riktw/nixiewatch/README.md

# Nixie (ok, panaplex) watch
hardware and software for a panaplex watch.

More info can be found on the corresponding [blog post.](https://justanotherelectronicsblog.com/?p=1190)
