riktw/nixiewatch/hw/Nixiewatch.pdf

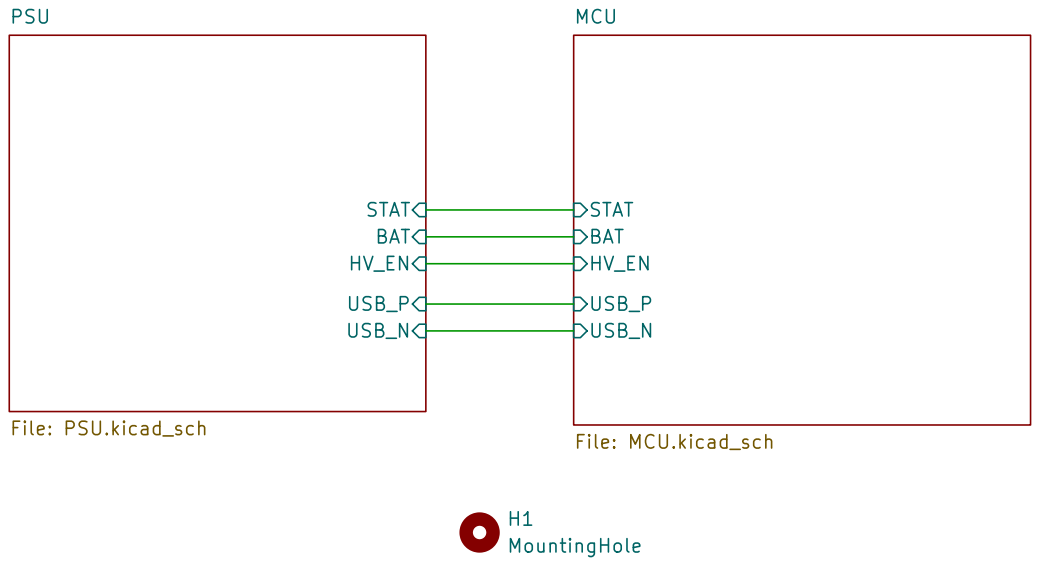
[picture p1: page 1]

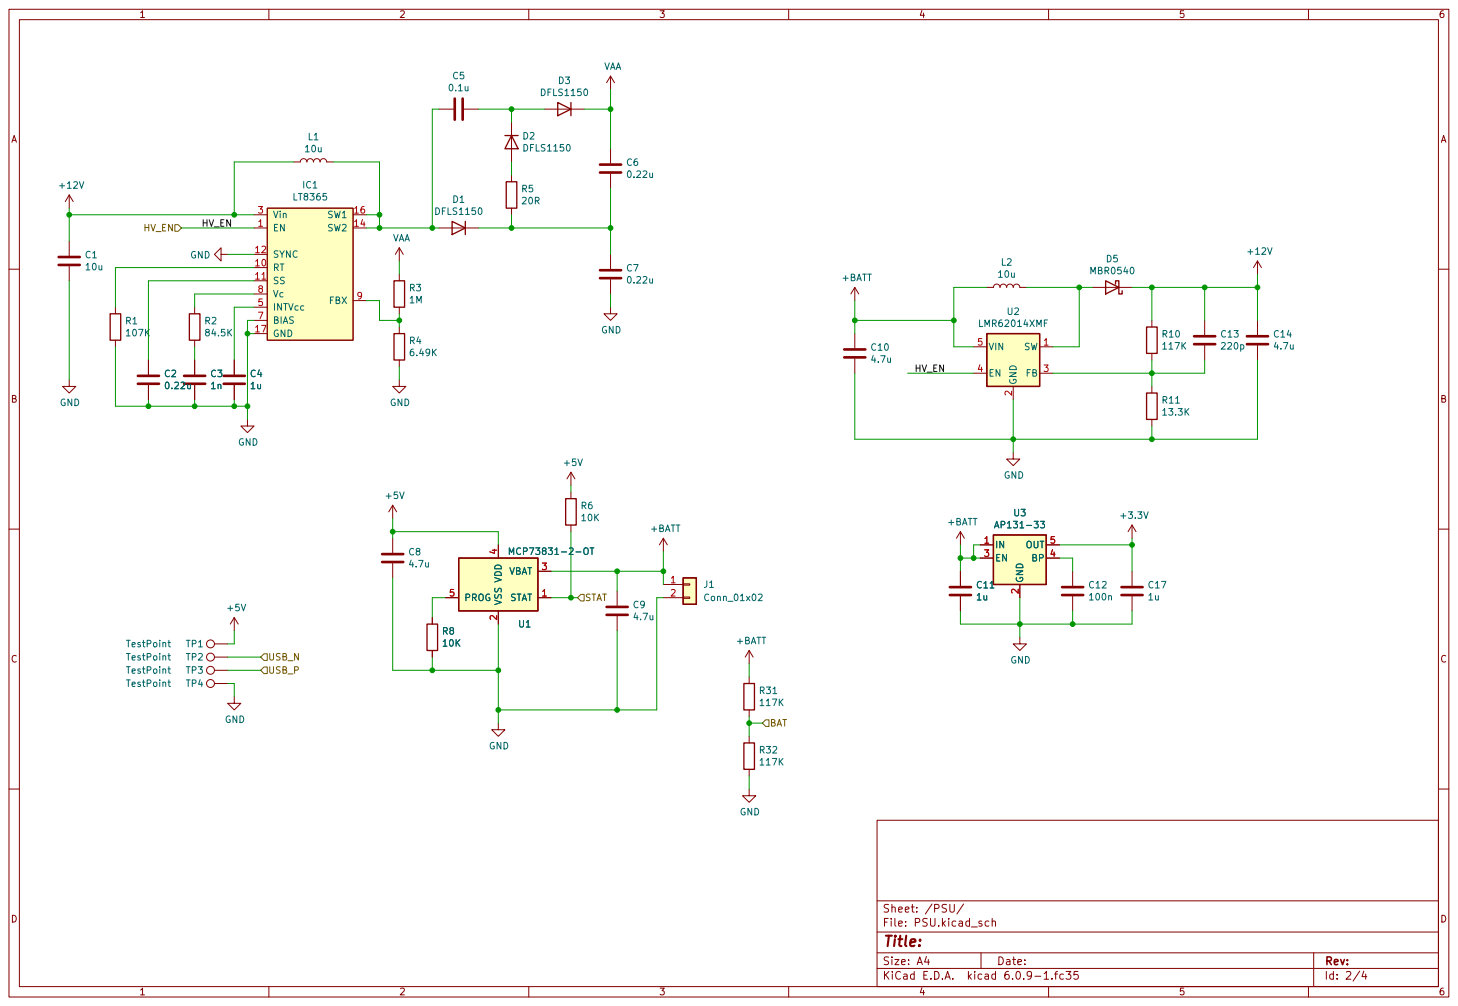
[picture p2: page 2]

2 EN 3 BP 4 OUT 5 U3 AP131-33 +BATT

File: PSU.kicad_sch Sheet: /PSU/
Id: 2/4 Title:

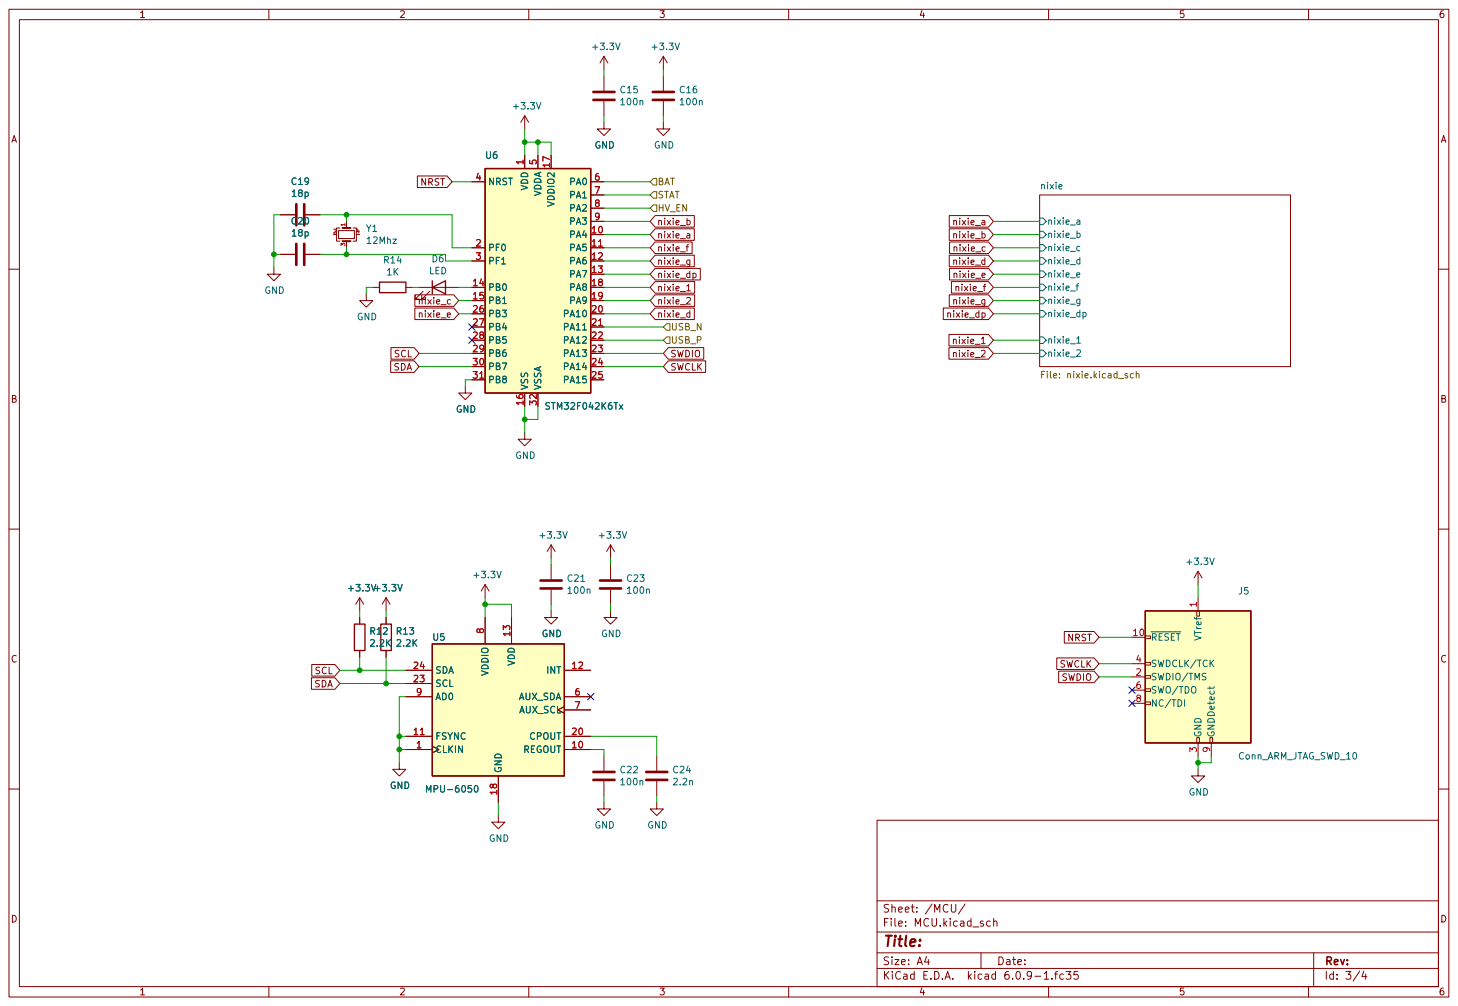
[picture p3: page 3]

1 PA4 10 PA5 11 PA6 12 PA7 13 PB0 14 PB1 15 VSS 16 VDDIO2 17 PA8 18 PA9 19 PF0 2 PA10 20 PA11 21 PA12 22 PA13 23 PA14 24 PA15 25 PB3 26 PB4 27 PB5 28 PB6 29 PF1 3 PB7 30 PB8 31 VSSA 32 NRST 4 VDDA

3 SWDCLK/TCK 4 SWO/TDO 6 NC/TDI 8 GNDDetect 9

File: MCU.kicad_sch Sheet: /MCU/
Id: 3/4 Title:

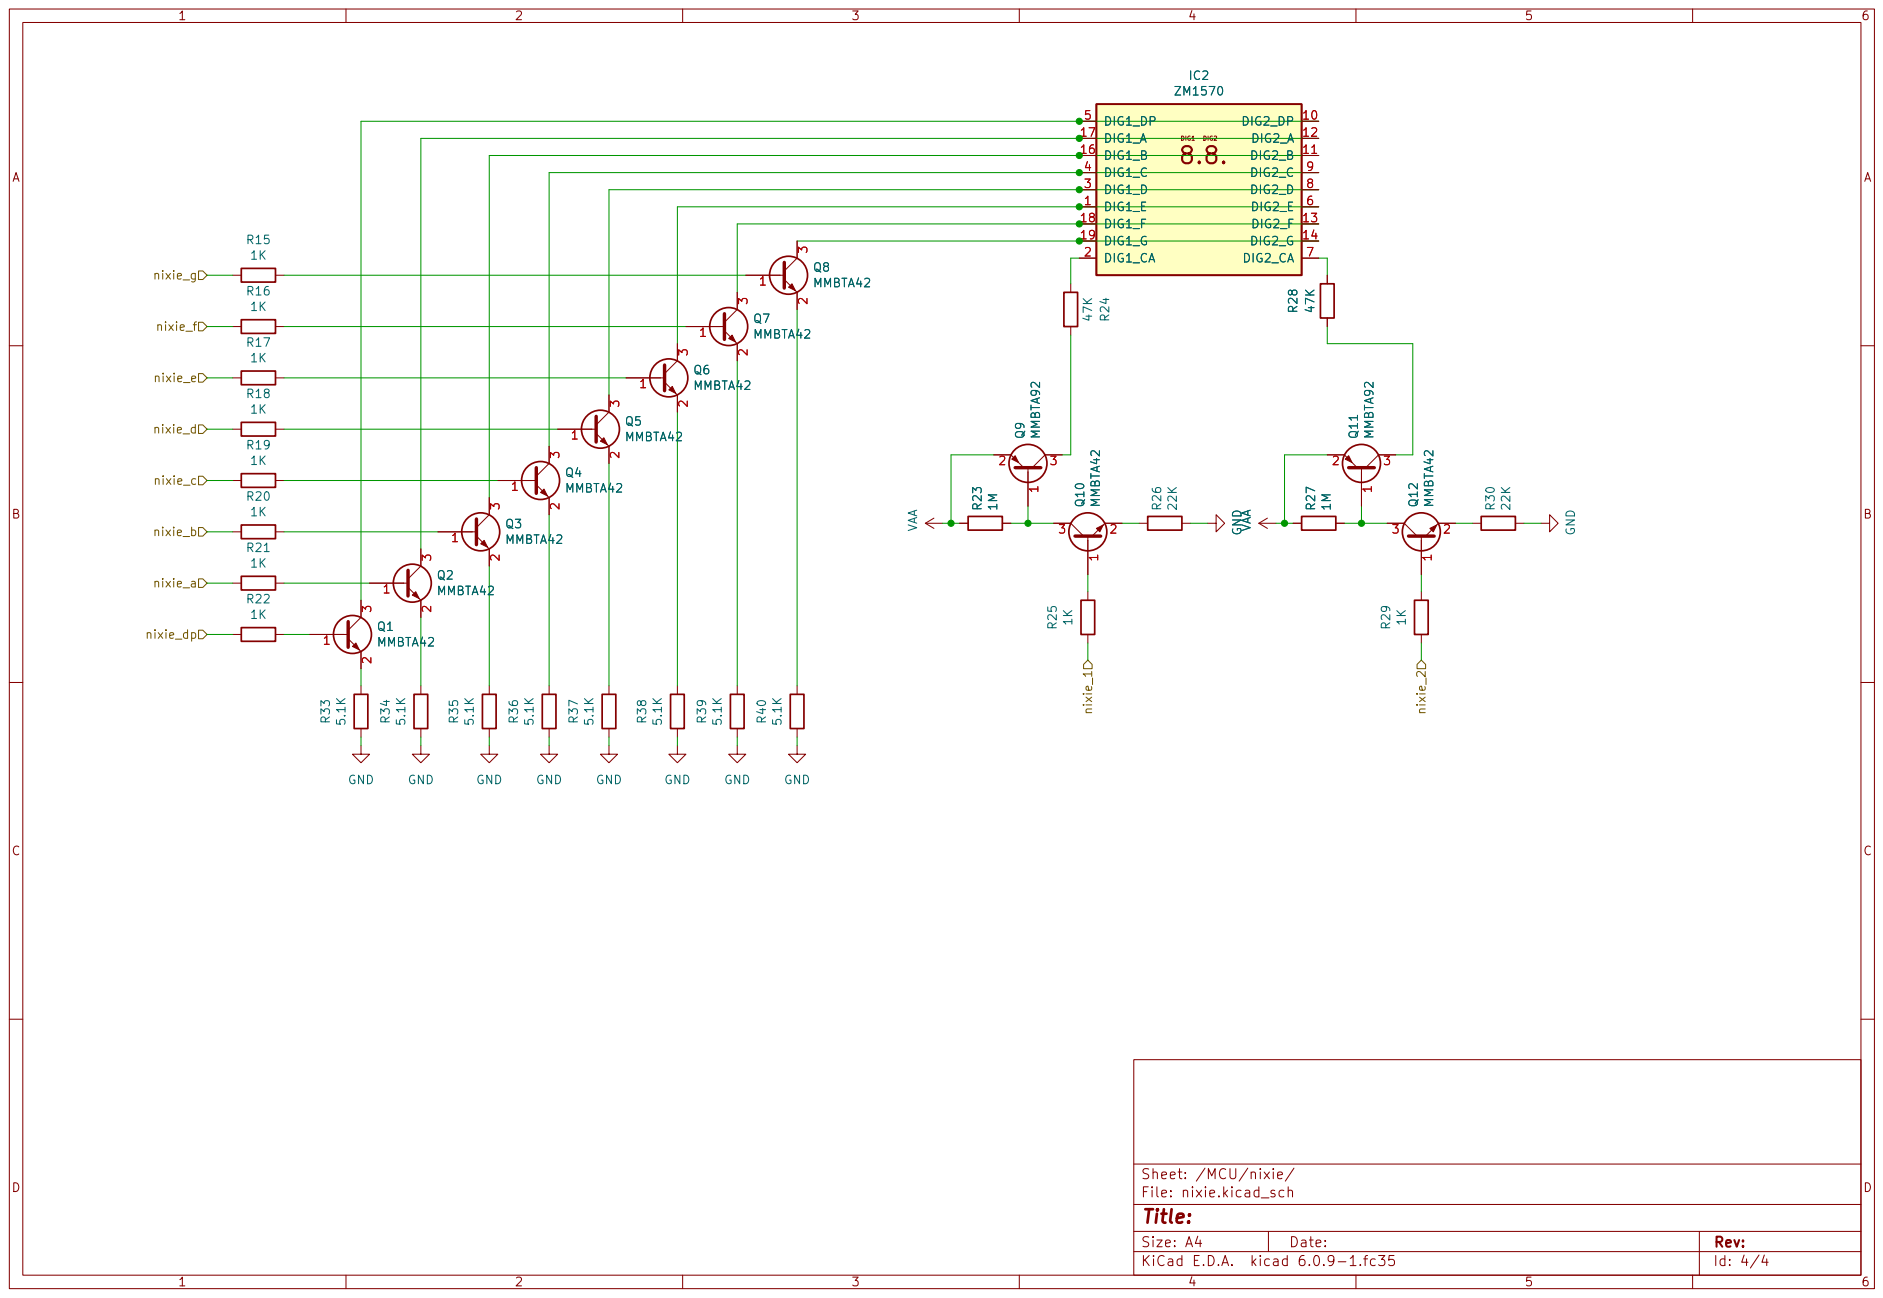
[picture p4: page 4]

File: nixie.kicad_sch Sheet: /MCU/nixie/
Id: 4/4 Title:
