riktw/nixiewatch/hw/Nixiewatch.kicad_pcb

## KiCad design hw/Nixiewatch.kicad_pcb (2022-12-20)

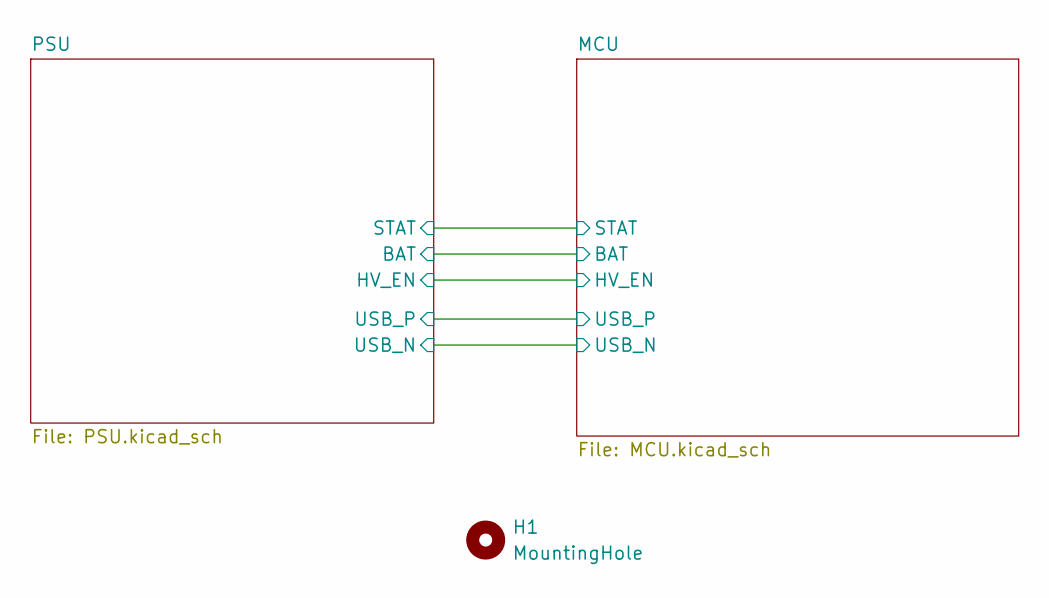
[picture p5: schematic Nixiewatch.kicad_sch]

Parts:
H1: MountingHole; MountingHole_2.2mm_M2

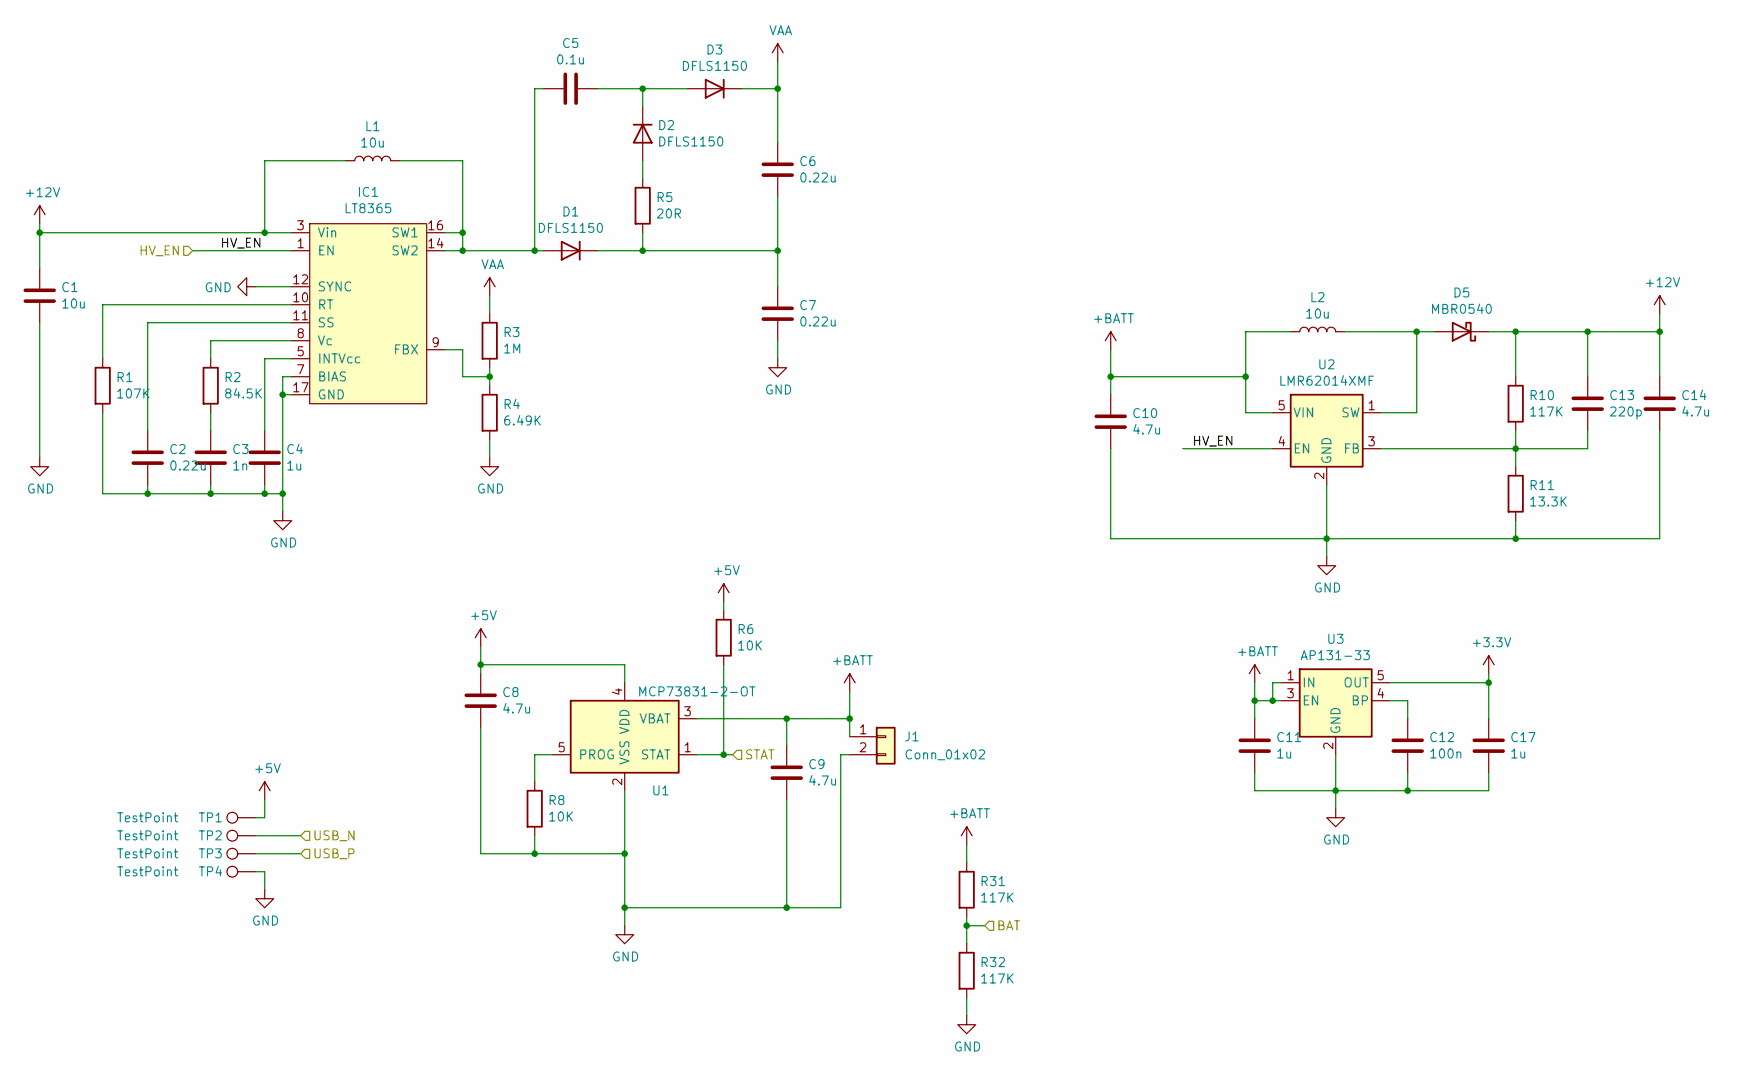
[picture p6: schematic PSU.kicad_sch]

Parts:
C1: 10u; C_0805_2012Metric_Pad1.15x1.40mm_HandSolder
C2: 0.22u; C_0603_1608Metric
C3: 1n; C_0603_1608Metric
C4, C11, C17: 1u; C_0603_1608Metric
C5: 0.1u; C_1206_3216Metric
C6, C7: 0.22u; C_1206_3216Metric
C8, C9, C10, C14: 4.7u; C_0603_1608Metric
C12: 100n; C_0603_1608Metric; LCSC C14663
C13: 220p; C_0603_1608Metric
D1, D2, D3: DFLS1150; D_SOD-123
D5: MBR0540; D_SOD-123
IC1: LT8365; MSOP-16-3x4.039_HV
J1: Conn_01x02; PinHeader_1x02_P2.54mm_Vertical
L1, L2: 10u; L_Coilcraft_XxL4020
R1: 107K; R_0603_1608Metric
R2: 84.5K; R_0603_1608Metric
R3: 1M; R_1206_3216Metric
R4: 6.49K; R_0603_1608Metric
R5: 20R; R_0603_1608Metric
R6, R8: 10K; R_0603_1608Metric
R10, R31, R32: 117K; R_0603_1608Metric
R11: 13.3K; R_0603_1608Metric
TP1, TP2, TP3, TP4: TestPoint; TestPoint_Pad_D1.5mm
U1: MCP73831-2-OT; SOT-23-5
U2: LMR62014XMF; SOT-23-5
U3: AP131-33; SOT-23-5

Connections:
+3V3: C17.1, U3.5 (OUT); also elsewhere on the board
+5V: C8.1, R6.1, TP1.1, U1.4 (VDD)
+12V: C1.1, C13.1, C14.1, D5.1 (K), IC1.3 (Vin), L1.1, R10.1
+BATT: C9.1, C10.1, C11.1, J1.1, L2.1, R31.1, U1.3 (VBAT), U2.5 (VIN), U3.1 (IN), U3.3 (EN)
/MCU/BAT: R31.2, R32.1; also elsewhere on the board
/MCU/STAT: R6.2, U1.1 (STAT); also elsewhere on the board
/MCU/USB_N: TP2.1; also elsewhere on the board
/MCU/USB_P: TP3.1; also elsewhere on the board
/PSU/HV_EN: IC1.1 (EN), U2.4 (EN); also elsewhere on the board
GND: C1.2, C2.2, C3.2, C4.2, C7.2, C8.2, C9.2, C10.2, C11.2, C12.2, C14.2, C17.2, IC1.7 (BIAS), IC1.12 (SYNC), IC1.17 (GND), J1.2, R1.2, R4.2, R8.2, R11.2, R32.2, TP4.1, U1.2 (VSS), U2.2 (GND), U3.2 (GND); also elsewhere on the board
unnamed: C2.1, IC1.11 (SS)
unnamed: C3.1, R2.2
unnamed: C4.1, IC1.5 (INTVcc)
unnamed: C5.1, D1.2 (A), IC1.14 (SW2), IC1.16 (SW1), L1.2
unnamed: C5.2, D2.1 (K), D3.2 (A)
unnamed: C6.2, C7.1, D1.1 (K), R5.2
unnamed: C12.1, U3.4 (BP)
unnamed: C13.2, R10.2, R11.1, U2.3 (FB)
unnamed: D2.2 (A), R5.1
unnamed: D5.2 (A), L2.2, U2.1 (SW)
unnamed: IC1.8 (Vc), R2.1
unnamed: IC1.9 (FBX), R3.2, R4.1
unnamed: IC1.10 (RT), R1.1
unnamed: R8.1, U1.5 (PROG)
VAA: C6.1, D3.1 (K), R3.1; also elsewhere on the board

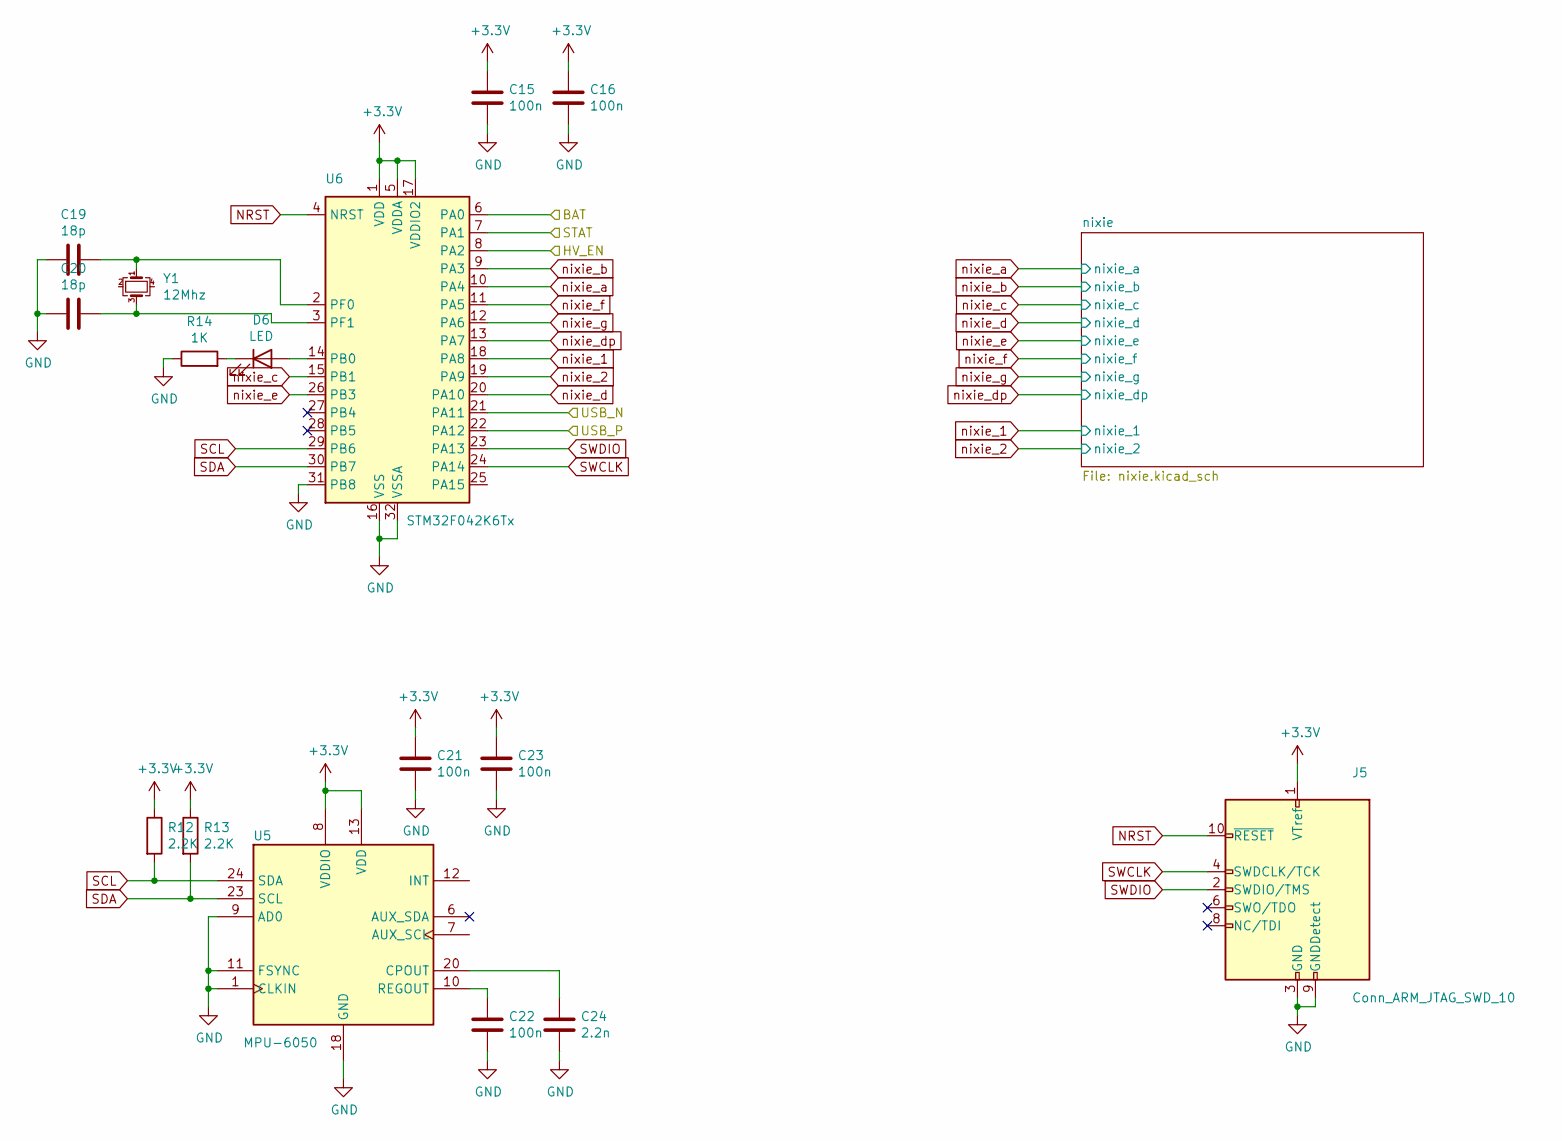
[picture p7: schematic MCU.kicad_sch]

Parts:
C15, C16, C21, C22, C23: 100n; C_0603_1608Metric; LCSC C14663
C19, C20: 18p; C_0603_1608Metric
C24: 2.2n; C_0603_1608Metric
D6: LED; LED_0603_1608Metric_Pad1.05x0.95mm_HandSolder
J5: Conn_ARM_JTAG_SWD_10; PinHeader_2x05_P1.27mm_Vertical_SMD
R12, R13: 2.2K; R_0603_1608Metric
R14: 1K; R_0603_1608Metric
U5: MPU-6050; InvenSense_QFN-24_4x4mm_P0.5mm
U6: STM32F042K6Tx; LQFP-32_7x7mm_P0.8mm
Y1: 12Mhz; Crystal_SMD_3225-4Pin_3.2x2.5mm_HandSoldering

Connections:
+3V3: C15.1, C16.1, C21.1, C23.1, J5.1 (VTref), R12.1, R13.1, U5.8 (VDDIO), U5.13 (VDD), U6.1 (VDD), U6.5 (VDDA), U6.17 (VDDIO2); also elsewhere on the board
/MCU/BAT: U6.6 (PA0); also elsewhere on the board
/MCU/STAT: U6.7 (PA1); also elsewhere on the board
/MCU/USB_N: U6.21 (PA11); also elsewhere on the board
/MCU/USB_P: U6.22 (PA12); also elsewhere on the board
/PSU/HV_EN: U6.8 (PA2); also elsewhere on the board
GND: C15.2, C16.2, C19.2, C20.2, C21.2, C22.2, C23.2, C24.2, J5.3 (GND), J5.5 (GND), J5.9 (GNDDetect), R14.1, U5.1 (CLKIN), U5.9 (AD0), U5.11 (FSYNC), U5.18 (GND), U6.16 (VSS), U6.31 (PB8), U6.32 (VSSA); also elsewhere on the board
NRST: J5.10 (~RESET), U6.4 (NRST)
unnamed: C19.1, U6.2 (PF0), Y1.1
unnamed: C20.1, U6.3 (PF1), Y1.3
unnamed: C22.1, U5.10 (REGOUT)
unnamed: C24.1, U5.20 (CPOUT)
unnamed: D6.1 (K), R14.2
unnamed: D6.2 (A), U6.14 (PB0)
SCL: R12.2, U5.24 (SDA), U6.29 (PB6)
SDA: R13.2, U5.23 (SCL), U6.30 (PB7)
SWCLK: J5.4 (SWDCLK/TCK), U6.24 (PA14)
SWDIO: J5.2 (SWDIO/TMS), U6.23 (PA13)
nixie_1: U6.18 (PA8); also elsewhere on the board
nixie_2: U6.19 (PA9); also elsewhere on the board
nixie_a: U6.10 (PA4); also elsewhere on the board
nixie_b: U6.9 (PA3); also elsewhere on the board
nixie_c: U6.15 (PB1); also elsewhere on the board
nixie_d: U6.20 (PA10); also elsewhere on the board
nixie_dp: U6.13 (PA7); also elsewhere on the board
nixie_e: U6.26 (PB3); also elsewhere on the board
nixie_f: U6.11 (PA5); also elsewhere on the board
nixie_g: U6.12 (PA6); also elsewhere on the board

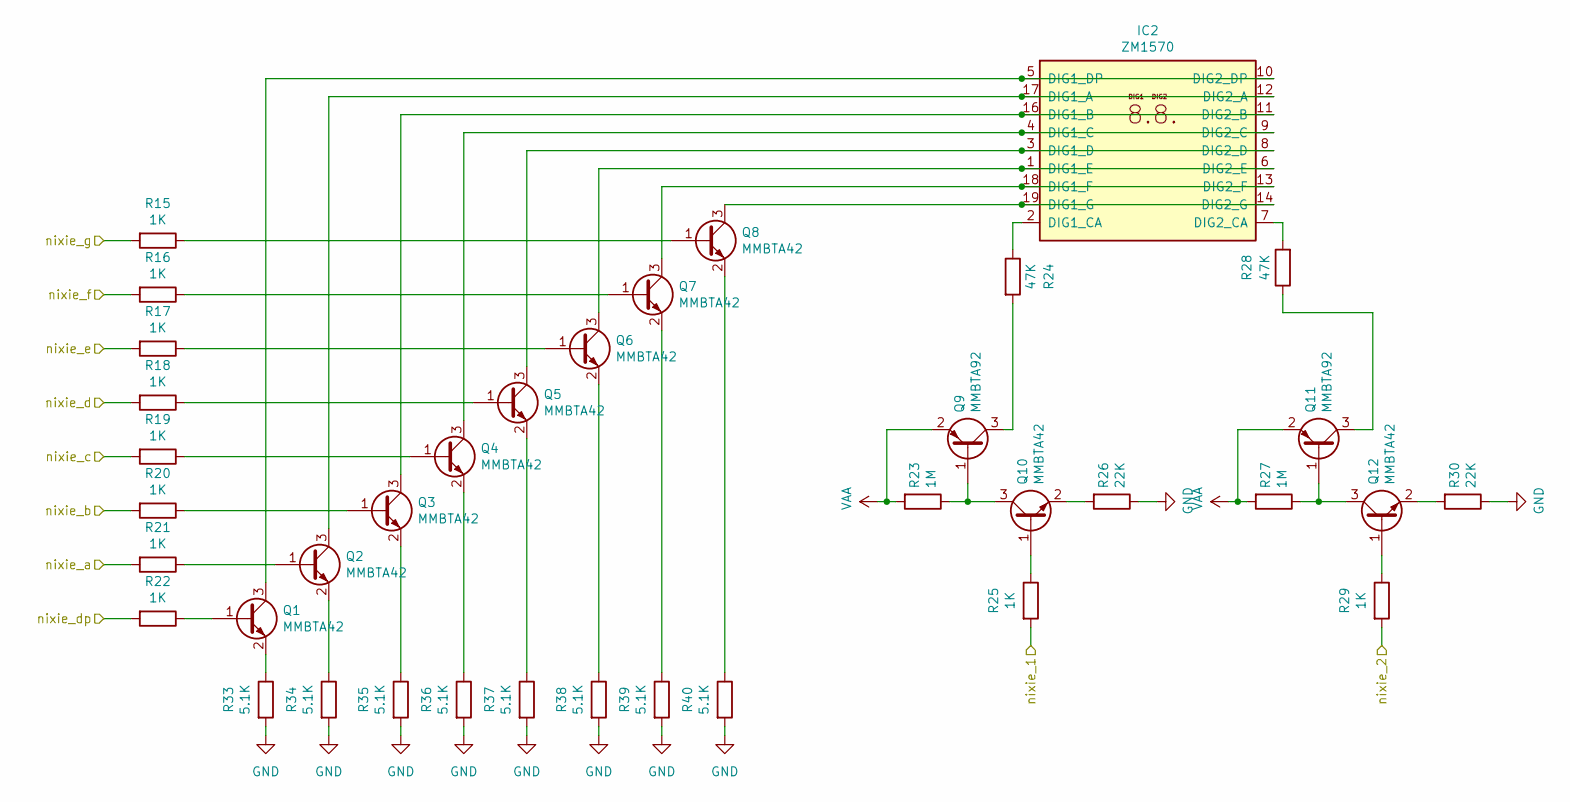
[picture p8: schematic nixie.kicad_sch]

Parts:
IC2: ZM1570
Q1, Q2, Q3, Q4, Q5, Q6, Q7, Q8, Q10, Q12: MMBTA42; SOT-23
Q9, Q11: MMBTA92; SOT-23
R15, R16, R17, R18, R19, R20, R21, R22, R25, R29: 1K; R_0603_1608Metric
R23, R27: 1M; R_0603_1608Metric
R24, R28: 47K; R_0805_2012Metric_Pad1.15x1.40mm_HandSolder
R26, R30: 22K; R_0603_1608Metric
R33, R34, R35, R36, R37, R38, R39, R40: 5.1K; R_0603_1608Metric

Connections:
GND: R26.1, R30.1, R33.2, R34.2, R35.2, R36.2, R37.2, R38.2, R39.2, R40.2; also elsewhere on the board
unnamed: IC2.1 (DIG1_E), IC2.6 (DIG2_E), Q6.3 (C)
unnamed: IC2.2 (DIG1_CA), R24.1
unnamed: IC2.3 (DIG1_D), IC2.8 (DIG2_D), Q5.3 (C)
unnamed: IC2.4 (DIG1_C), IC2.9 (DIG2_C), Q4.3 (C)
unnamed: IC2.7 (DIG2_CA), R28.2
unnamed: IC2.5 (DIG1_DP), IC2.10 (DIG2_DP), Q1.3 (C)
unnamed: IC2.11 (DIG2_B), IC2.16 (DIG1_B), Q3.3 (C)
unnamed: IC2.12 (DIG2_A), IC2.17 (DIG1_A), Q2.3 (C)
unnamed: IC2.13 (DIG2_F), IC2.18 (DIG1_F), Q7.3 (C)
unnamed: IC2.14 (DIG2_G), IC2.19 (DIG1_G), Q8.3 (C)
unnamed: Q1.1 (B), R22.1
unnamed: Q1.2 (E), R33.1
unnamed: Q2.1 (B), R21.1
unnamed: Q2.2 (E), R34.1
unnamed: Q3.1 (B), R20.1
unnamed: Q3.2 (E), R35.1
unnamed: Q4.1 (B), R19.1
unnamed: Q4.2 (E), R36.1
unnamed: Q5.1 (B), R18.1
unnamed: Q5.2 (E), R37.1
unnamed: Q6.1 (B), R17.1
unnamed: Q6.2 (E), R38.1
unnamed: Q7.1 (B), R16.1
unnamed: Q7.2 (E), R39.1
unnamed: Q8.1 (B), R15.1
unnamed: Q8.2 (E), R40.1
unnamed: Q9.3 (C), R24.2
unnamed: Q10.1 (B), R25.1
unnamed: Q10.2 (E), R26.2
unnamed: Q9.1 (B), Q10.3 (C), R23.1
unnamed: Q11.1 (B), Q12.3 (C), R27.1
unnamed: Q11.3 (C), R28.1
unnamed: Q12.1 (B), R29.1
unnamed: Q12.2 (E), R30.2
VAA: Q9.2 (E), Q11.2 (E), R23.2, R27.2; also elsewhere on the board
nixie_1: R25.2; also elsewhere on the board
nixie_2: R29.2; also elsewhere on the board
nixie_a: R21.2; also elsewhere on the board
nixie_b: R20.2; also elsewhere on the board
nixie_c: R19.2; also elsewhere on the board
nixie_d: R18.2; also elsewhere on the board
nixie_dp: R22.2; also elsewhere on the board
nixie_e: R17.2; also elsewhere on the board
nixie_f: R16.2; also elsewhere on the board
nixie_g: R15.2; also elsewhere on the board

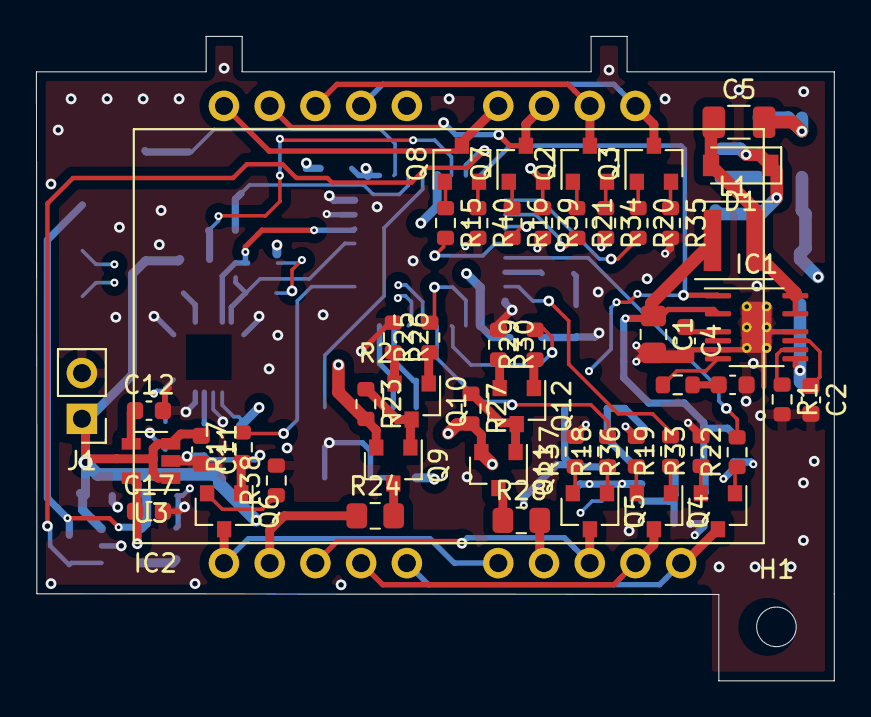
[picture p9: board Nixiewatch.kicad_pcb from above]

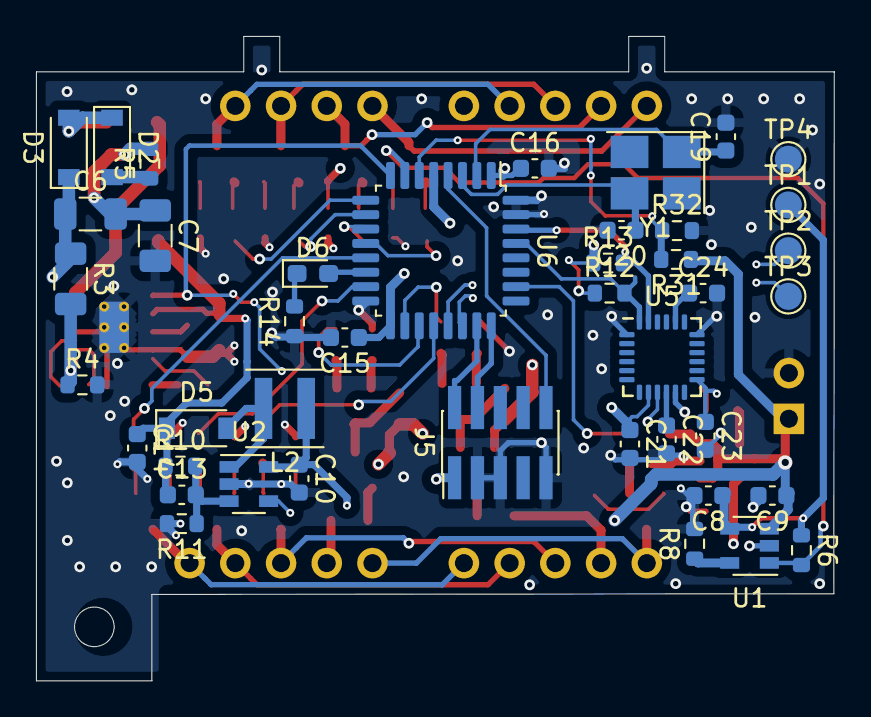
[picture p10: board Nixiewatch.kicad_pcb from below]

Board: 4 copper layers, 44.3 x 35.8 mm, 95 parts (42 on the bottom side), 80 nets.
